KingVanilla/LoRa-Environmental-Sensor-Base-Station/Arduino code/ESP_publisher/WiFi.ino

void networkInitialization() {
  delay(250);
  Serial.print("Network initialization started.  Connecting to: ");
  Serial.print(ssid);

  WiFi.begin(ssid, password);
  WiFi.mode(WIFI_STA);

  while (WiFi.status() != WL_CONNECTED) {
    delay(1000);
    Serial.print(".");
  }

  randomSeed(micros());

  Serial.println("");
  Serial.print("IP address: ");
  Serial.println(WiFi.localIP());

  mqttClient.setServer(mqtt_server, 1883);
}

void reconnect() {
  while (!wifiClient.connected()) {
    Serial.print("Attempting MQTT connection...");
    // Create a random client ID
    String clientId = "ESP8266Client-";
    clientId += String(random(0xffff), HEX);
    // Attempt to connect
    if (mqttClient.connect(clientId.c_str())) {
      Serial.println("connected");
    } else {
      Serial.print("failed, rc=");
      Serial.print(mqttClient.state());
      Serial.println(" try again in 5 seconds");
      // Wait 1 second before retrying
      delay(1000);
    }
    Serial.println("Network initialization complete");
  }
}
